Audio-Rochey/TerrainTronics-Harlech-Castle/Harlech-WifiWithTrigger/readme.md

#  Terrain Tronics Harlech Example Code
## Wifi Setup with LED's and General Purpose triggers.

**7/1/2022 - A very early version of this document. Let's call it version 0.1**

> Any questions on how this code works can be posted here in github in the issues.

The code in this example is designed to run on a Wemos D1 Processor, developed in the arduino environment, with an assembled Terrain Tronics Harlech Castle board on it.

Regular assembled Harlech

The Harlech board is designed to run with 8 different LED output that can be controlled from the Wemos D1 Mini. In this case, a few of the channels near the top (nearest the antenna) have been replaced with a pull up resistor of 10KOhm. 

Harlech behaves like a serial to parallel connection, but rather than sending each pin to a high voltage and having the lower pin (the cathode of the LED) have a shared GND, This method is called "high side swithing". Harlech castle works by having a shared high voltage, then using "lower side switches" to switch on and controle the LED's. (known as low side swithing). Thought of in another way, Harlech switches on ground when you send a 1, pulling the voltage at it's pin to ground.

this is commonly done with mechanical switches as it means that one side of the switch is connected to the microcontroller, and the other side can pick up a ground signal from anywhere on the circuit board. easier than trying to find a high voltage!

Modified board for triggers

The pins in the center strip of the Harlech board are your output pins. The strip of pins closest to the IC are either virtually disconnected, or connected to ground (through a fixed current).

# How the code works.

To learn how to download/compile code to your Harlech board, watch this video: https://www.youtube.com/watch?v=TgE-Op0UvxE

You'll also need a few additional libraries. WifiManager, WebSocketServer and Double Reset Detector are the ones that come to mind.

The first time you download the code, the board will reset and then setup it's own WiFi network for you to connect from your phone/computer, to teach it about your home network. **If you use the serial monitor that is built into the Arduino Development tools, you can watch information come back from the board. Useful to see what's being sent to the board and what's going on with the server!**

Example feedback from Arduino Serial Monitor

Once you've configured the board for your wifi network, you'll need to find out which IP address it was given. this can be done using your wifi routers internal webpage, or looking the data on the arduino monitor. you should be able to find the server on your network at http://TerrainTronics01/

From there, a html file is brought up on your mobile or your pc with a few buttons, similar to the following:

# How to modify the code - the basics

The code uses *websockets* to communicate from your browser (whether it's a phone or a pc, or anything else). Websockets are a streamlined way of communicating with servers. The htmlfile.h describes the file that is sent to your browser when you connect. 
To make a new button pop up on your GUI, then you need to add an additional line to this text.
```<button id='BTN_LEDA'class="button">Trigger Sound Effect board</button>
      <button id='BTN_LEDB'class="button">Lights On</button>
      <button id='BTN_LEDC'class="button">Lights Off</button>
      <button id='BTN_LEDD'class="button">Run LED Pattern</button>
```

That handles the bit that's shown, then we need to teach it what do when one of those buttons is pressed... so a little further down at: 

```document.getElementById('BTN_LEDB').addEventListener('click', buttonBClicked);
  function buttonBClicked()
  {   
    sendText('1');
  }
```

What that code is telling your browser is that when button B is clicked ("light on"), then run a mini program, or function, called "buttonBClicked", which conveniently is int he following lines. In this case, it sends text of "1".

So to add a button, add a button, make it... BTN_LED**E** for instance, and make sure you add a document.getElementById bit too.

Now lets look over at HarlechC1p1-BasicWifi

Here, there's a function (subroutine) that checks what text was recieved. Search for a line of code that says 
`void webSocketEvent(byte num, WStype_t type, uint8_t * payload, size_t length)`

below it are a bunch of if/else statements. There are a few examples here. We'll cover the easy ones first! :)

> **Please note, where you see 0b00000001 - each 0 or 1 is connected to a pin. 8 pins, 8 0's and 1's. The least significant 0/1 is the highest output pin on the board.**

### Switching things ON or OFF from a button.

```else if (payload[0] == '1')
      {
          
          PatternRun.attach_ms(0, NULL);  // Stop any pattern running in the background.
          Serial.println("All Lights On"); // Send a debug message on the arduino monitor
          digitalWrite(latchPin, LOW); // Tells the LED driver IC to listen
          currentStaticHarlechOutputs = 0b11110000; // set 4 of the lower LED's to ON. (you'll likely do this)
          shiftOut(dataPin, clockPin, LSBFIRST, currentStaticHarlechOutputs);
          digitalWrite(latchPin, HIGH); // Tells the LED driver 
          analogWrite(OE, 0); // This is for brightness control. 0 is full brightness, 255 is the lowest... BUT this will stop your trigger functions working very well.
          delay(5);
      }

```

### Trigger Switcher

This one switches of the triggers on, then off again. This should be enough to trigger audio playback from an off the shelf module that looks for changing edges.

```else if (payload[0] == 't')
      {
          Serial.println("Trigger");    // <--- sends text back to the Arduino Monitor.
          digitalWrite(latchPin, LOW); // Tells the LED driver IC to listen
          shiftOut(dataPin, clockPin, LSBFIRST, (currentStaticHarlechOutputs | 0b00000001)); // bitwise OR to set the bits high.
          digitalWrite(latchPin, HIGH); // Tells the LED driver to latch
          delay (200); // add a 200mS delay.
          digitalWrite(latchPin, LOW); // Now reset the value back to how it was.
          shiftOut(dataPin, clockPin, LSBFIRST, (currentStaticHarlechOutputs & 0b11111110)); // bitwise AND to set those pins back to currentStatic
          digitalWrite(latchPin, HIGH); // Tells the LED driver to latch
          analogWrite(OE, 0);
          delay(5);
      }
      
```

# Bonus Points - using a Stream Deck!

Well done for reading all the way to the bottom.
There's a plugin for the streamdeck called "Web Requests" - very easy to intall in their GUI. The Authors name is Adrian Mullings, if that helps!

GUI screenshot

I simply set the URL to: ws://192.168.1.70:81/  (my network gave the address 192.168.1.70 to the Wemos D1)
Then set the message to be 0 or 1 or t or whatever I want the message to be.
