Audio-Rochey/TerrainTronics-Harlech-Castle/(threads)

Thread 2 (2021-03-01):

Harlech PG1.0 - R2 Pot needs pin 2 and 3 shorted together

Audio-Rochey, 2021-03-01:
Pin 2 currently not connected to anything - requiring a jumper on all manufactured boards.

Audio-Rochey, 2021-03-12:
Updated in Schematic.

Closed 2021-03-12.

Thread 3 (2021-03-01):

Harlech PG1.0 - Bring out SDO from SM16106

Audio-Rochey, 2021-03-01:
Current board doesn't allow for daisy chaining boards.

Audio-Rochey, 2021-03-12:
DONE

Closed 2021-03-12.

Thread 4 (2021-03-01):

Harlech PG1.0 - Pulldown on input to the transistor keepalive circuit.

Audio-Rochey, 2021-03-01:
Q1 is a mosfet. (e.g. 2n7002).
The pin on the Wemos D1 is floating (input) by default which means that in some cases the Mosfet switches on by mistake.

The code example pulls D3 low as soon as possible, but if somone plugs Harlech on to a unprogrammed board, the transistor will get hot and drive a lot of heat through the little resistor!

Audio-Rochey, 2021-03-12:
UPdated on Schematic and on layout

Closed 2021-03-12.

Thread 5 (2021-03-01):

Harlech PG1.0 - Bring out D0 and D7 to pins.

Audio-Rochey, 2021-03-01:
Allow further hacking as D0 and D7 aren't currently used.

Audio-Rochey, 2021-03-01:
Do we have room for a PH connector to use a neopixel?

Audio-Rochey, 2021-03-12:
> Do we have room for a PH connector to use a neopixel?

No room.

HOwever, D0 and D7 have been brought out.

Closed 2021-03-12.

Thread 6 (2021-03-01):

Harlech PG1.0 - Allow !OE to be D4 by default, but easily switches to D7

Audio-Rochey, 2021-03-01:
Add a solder jumper to switch OE source.
This is because some libraries use D4 directly and clash (e.g. some of the WiFi libraries)

Audio-Rochey, 2021-03-12:
Compromised. D4 or D3 can be selected using a solder jumper. D7 is brought out elsewhere, so it could be wire jumpered over.

Closed 2021-03-12.

Thread 7 (2021-03-02):

Harlech PG1.0 - Add LED to 5V rail.

Audio-Rochey, 2021-03-02:
low current LED is enough. 2mA?

Audio-Rochey, 2021-03-02:
Assuming 5V supply, 2Vdrop red led. Using a 1K resistor would drop 3mA across the LED.
Perfect. Also easily desoldered if required.

Audio-Rochey, 2021-03-12:
done. in layout and in schematic.

Closed 2021-03-12.

Thread 8 (2021-03-12):

Harlech PG1.0 - New pinout.

Audio-Rochey, 2021-03-12:
Pinout changed
Mainly because some pins on the Wemos D1 Mini can't support pull up/downs by default etc.

| Pin | Notes about pin                | Harlech PG1p0 | Harlech PG1p1       |
|-----|--------------------------------|---------------|---------------------|
| D0  | No PWM possible                | SPARE         | KEEPALIVE           |
| D1  | Often used as SCL              | I2C-SCL       | I2C-SCL             |
| D2  | Often used as SDA              | I2C-SDA       | I2C-SDA             |
| D3  | No Pulldown allowed            | KEEPALIVE     | SPARE (optional OE) |
| D4  | LED. No Pulldown Allowed       | !OE           | SPARE               |
| D5  | Often used for SPI-CLK         | SPICLK        | SPICLK              |
| D6  | Often used for SPI-COPI        | SPI-COPI      | SPI-COPI            |
| D7  | Often used for SPI-CIPO        | SPARE         | !OE                 |
| D8  | No Pullup Allowed (Fail Boot). | SPI-CS        | SPI-CS              |
