Audio-Rochey/TerrainTronics-Harlech-Castle/Harlech_V1p1_Schematic.pdf

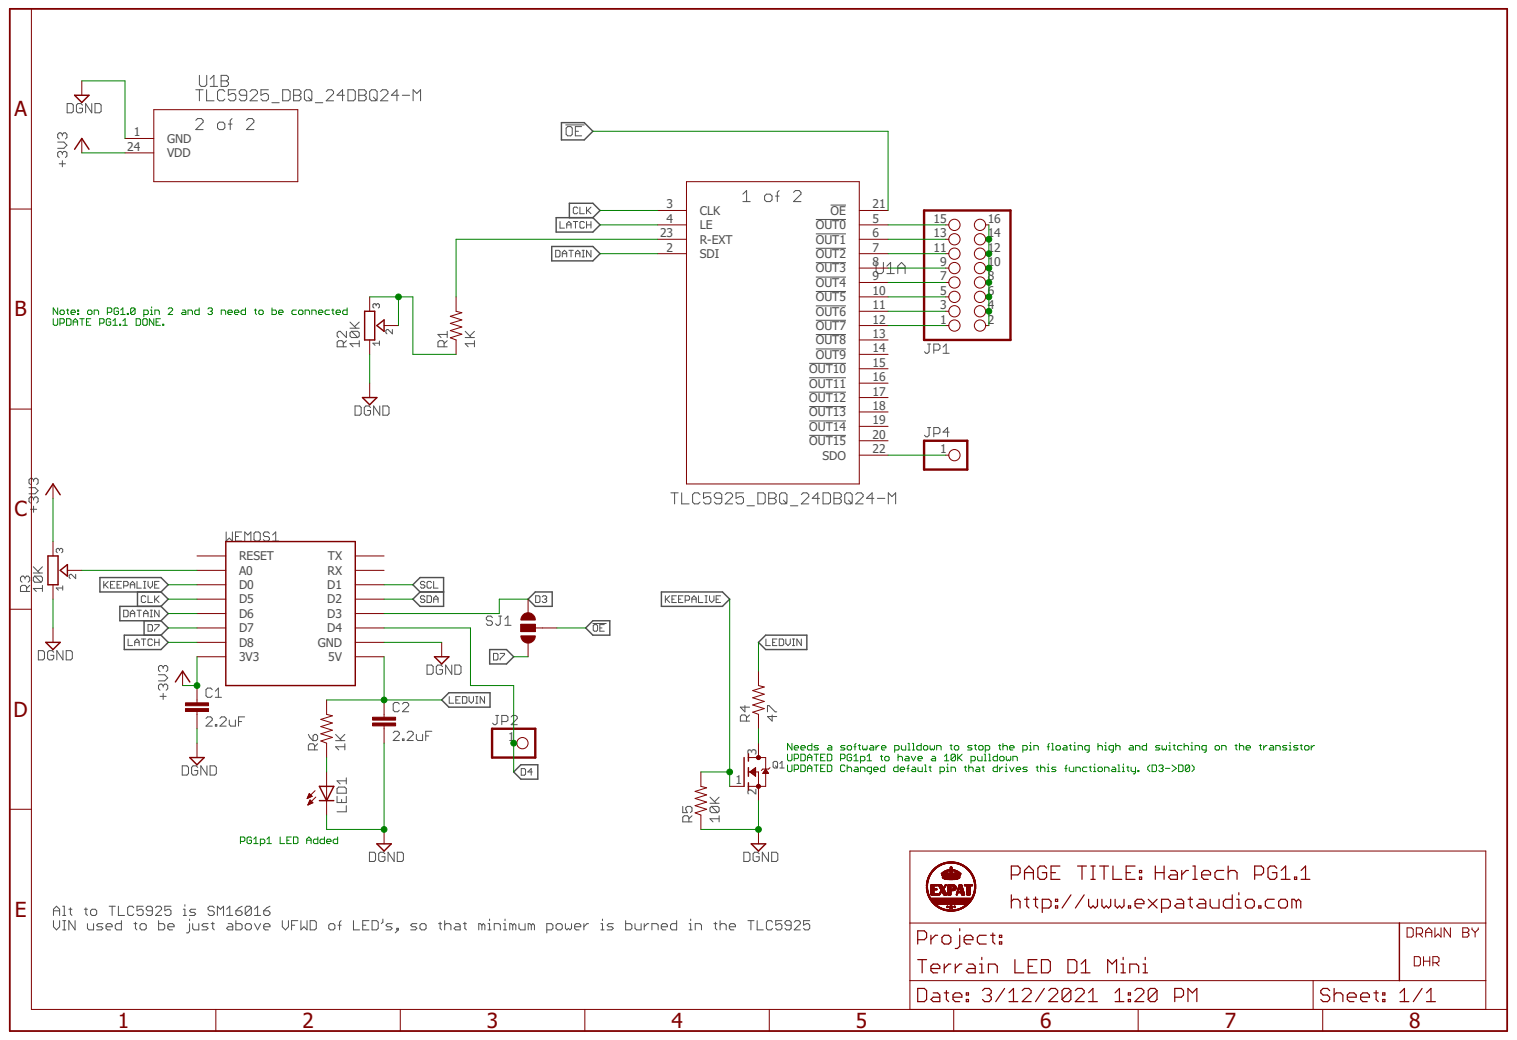
[picture p1: page 1]
