Audio-Rochey/TerrainTronics-Harlech-Castle/(commit log)

2021-05-19 UPdated with latest version of code.
    Be sure to change the Harlech hardware definition.
    Look for the line "#define harlechVer1p0"
    comment out whichever board you have. It'll compensate for the change in pinout.
2021-05-19 Initial upload of Binary Images to direct download
    Pick the right version depending on which version of Harlech you have. (look on the silkscreen, it says!)
2021-05-19 Uploaded the V1p1 Schematic
2022-11-18 Create Example-PWMeffects
2022-11-18 Create Harlech-PWMeffects.ino
    4 LED's working. 17kHz update rate.
2024-02-15 Update Harlech-SimplePattern.ino
    Updated for Harlech 1.1 (KeepAlive Pin and OE pin)
2025-08-28 Update Harlech-WifiMgrMultiScnWebSocket.ino
    Working a lot better. however, needs a reset after you've tought the board what your new network is,
    [Harlech-WifiMgrMultiScnWebSocket.ino]
2025-11-29 Update README with LED connector pinout details
    Added pinout information and images for LED connectors.
